jfri2/EV_DAQ_UNIT/Hardware/EV_DAQ_Unit.xlsx

Reference | Quantity | Quantity (2x) | Quantity (3x) | Value | Footprint | MFG# | DigiKey#
C11 C15 C19 C21 C22 C29 C30 C31 C38 C39 C4 C40 | 12 | 24 | 36 | 10uF | 1210 | TPSB106K020R0500 | 478-9048-1-ND
C23 C24 | 2 | 4 | 6 | 18pF | 603 | GRM1885C1H180FA01J | 490-10706-1-ND
C27 | 1 | 2 | 3 | 100uF | 2917 | T495D107M016ATE125 | 399-8502-1-ND
C1 C2 C37 | 3 | 6 | 9 | 10nF | 805 | GRM2195C1H103FA01D | 490-8295-1-ND
C10 C12 C13 C14 C16 C20 C25 C26 C28 C3 C32 C33 C34 C35 C41 C6 C8 | 17 | 34 | 51 | 100nF | 603 | C0603C104K3RACTU | 399-1281-1-ND
C36 C5 C7 C9 | 4 | 8 | 12 | 1uF | 805 | C0805C105J4RACTU | 399-8001-1-ND
D1 D12 D13 D14 | 4 | 8 | 12 | GREEN | 2-SMD, Z-Bend | SSL-LXA228GC-TR31 | SSL-LXA228GC-TR31
D10 D11 D8 D9 | 4 | 8 | 12 | CUS08F30 | SOD-323/SC-76 | CUS08F30,H3F | CUS08F30,H3F
D2 | 1 | 2 | 3 | S_RED | 2-SMD, Z-Bend | SSL-LXA228IC-TR31 | SSL-LXA228IC-TR31
D3 | 1 | 2 | 3 | 18V | SMA | 1SMA5931BT3G | 1SMA5931BT3GOSCT-ND
D6 D7 | 2 | 4 | 6 | YELLOW | 2-SMD, Z-Bend | SSL-LXA228YC-TR31 | 67-1392-1-ND
F1 | 1 | 2 | 3 | 500mA | 1812 | 0ZCG0050AF2C | 507-1762-1-ND
FB1 FB2 | 2 | 4 | 6 | BKP2125HS330-T | 805 | BKP2125HS330-T | 587-1931-1-ND
P1 | 1 | 2 | 3 | LOAD_CELL |  | 282834-5 | A98336-ND
P2 | 1 | 2 | 3 | PWR |  | 282834-2 | A98333-ND
P3 | 1 | 2 | 3 | AVR_ISP |  | PRPC040SAAN-RC | S1011EC-40-ND
P4 | 1 | 2 | 3 | USB_B |  | 61729-1011BLF | 609-3657-ND
P5 | 1 | 2 | 3 | HALL_EFFECT |  | 282834-6 | A98337-ND
R10 | 1 | 2 | 3 | 3.9k | 603 | RC0603FR-073K9L | 311-3.90KHRCT-ND
R13 R14 R26 R27 R30 R36 R38 | 7 | 14 | 21 | 470 | 805 | RC0805JR-07470RL | 311-470ARCT-ND
R11 R12 R15 R16 R17 R18 R19 R20 R21 R22 R23 R25 R33 R34 R35 R7 R8 | 17 | 34 | 51 | 39 | 603 | ESR03EZPJ390 | RHM39DCT-ND
R1 R2 R24 R3 R31 R32 R4 | 7 | 14 | 21 | 10k | 603 | ESR03EZPJ103 | RHM10KDCT-ND
R5 R6 R28 R29 R37 R39 R40 | 7 | 14 | 21 | 1k | 603 | RNCP0603FTD1K00 | RNCP0603FTD1K00CT-ND
R9 | 1 | 2 | 3 | 499 | 603 | RP73PF1J499RBTDF | A110079CT-ND
SW1 SW2 SW3 | 3 | 6 | 9 | SWITCH | TH | B3F-1022 | SW403-ND
U1 | 1 | 2 | 3 | LM4040-3.0V | SOT-23-3 | LM4040C30IDBZR | 296-20887-1-ND
U10 U12 | 2 | 4 | 6 | NCP5501-3V3 | DPAK-3 | NCP5501DT33RKG | NCP5501DT33RKGOSCT-ND
U11 | 1 | 2 | 3 | NCP5501-5V | DPAK-3 | NCP5501DT33RKG | NCP5501DT33RKGOSCT-ND
U2 | 1 | 2 | 3 | AD8226 | SOIC-8 | AD8226ARZ-R7 | AD8226ARZ-R7CT-ND
U3 | 1 | 2 | 3 | NHD-C0216CiZ | TH-CUSTOM | NHD-C0216CIZ-FSW-FBW-3V3 | NHD-C0216CIZ-FSW-FBW-3V3-ND
U4 | 1 | 2 | 3 | AD8616 | SOIC-8 | AD8616ARZ | AD8616ARZ-ND
U5 | 1 | 2 | 3 | LM2937-10V | SOT-223-4 | LM2937IMPX-10/NOPB | LM2937IMPX-10/NOPBCT-ND
U6 | 1 | 2 | 3 | FT232RL | SSOP-28 | FT232RL-REEL | 768-1007-1-ND
U7 | 1 | 2 | 3 | 74HC7014 | SOIC-14 | 74HC7014D,118 | 568-8162-1-ND
U13 U8 | 2 | 4 | 6 | TPD4E1U06 | SOT23-6 | TPD4E1U06DBVR | 296-35965-1-ND
U9 | 1 | 2 | 3 | TXB0106 | TSSOP-16 | TXB0106PWR | 296-23759-1-ND
U14 | 1 | 2 | 3 | ATMEGA328PB | 32 TQFP 0.8mm | ATMEGA328PB-AU | ATMEGA328PB-AU-ND
Y1 | 1 | 2 | 3 | 16_MHz | HC49-SMD | AT-16.000MAGE-T | 887-1608-1-ND
