jfri2/EV_DAQ_UNIT/Hardware/PDFs/EV_DAQ_Unit.pdf

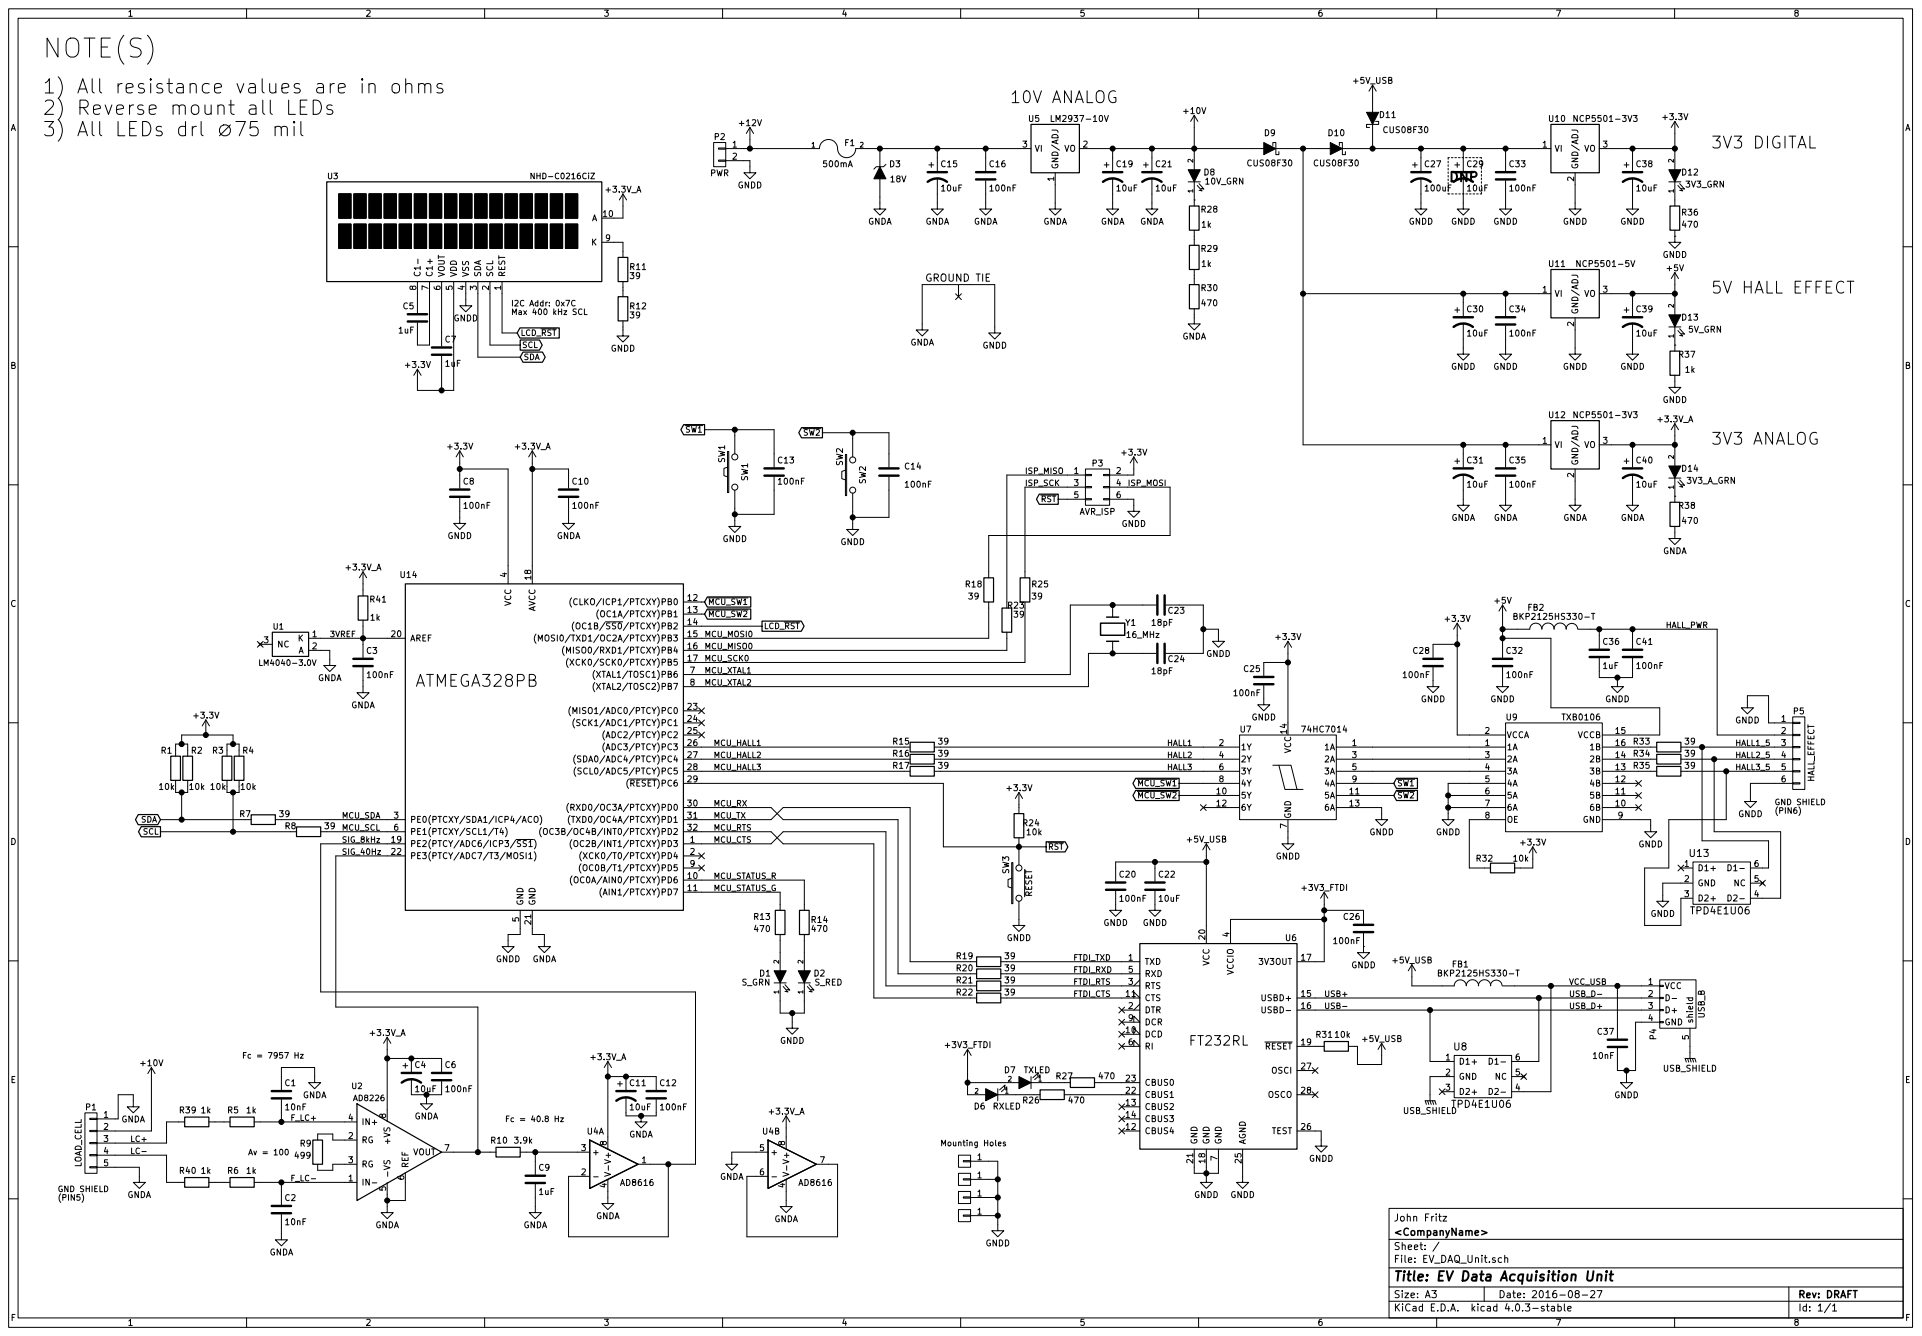
[picture p1: page 1]

NOTE(S)
10k 1) All resistance values are in ohms
2) Reverse mount all LEDs
3) All LEDs drl 75 mil

I2C Addr: 0x7C Max 400 kHz SCL

7 DCR 9 DCD 10 VCC 20 CTS 11 GND 21 CBUS4 12 CBUS1 22 CBUS2 13 CBUS0 23 CBUS3 14 USBD+ 15 AGND 25 USBD- 16 TEST 26

John Fritz
File: EV_DAQ_Unit.sch Sheet: / <CompanyName>

Id: 1/1 Title: EV Data Acquisition Unit
