jfri2/EV_DAQ_UNIT/Hardware/PDFs/EV_DAQ_Unit-B.CrtYd.pdf

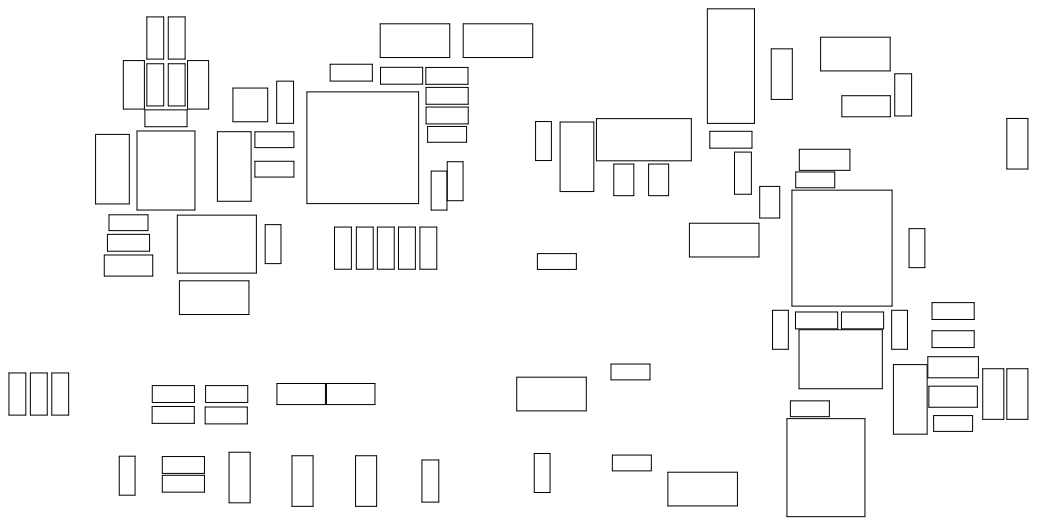
[picture p2: page 1]
