jfri2/EV_DAQ_UNIT/Hardware/PDFs/EV_DAQ_Unit-B.Cu.pdf

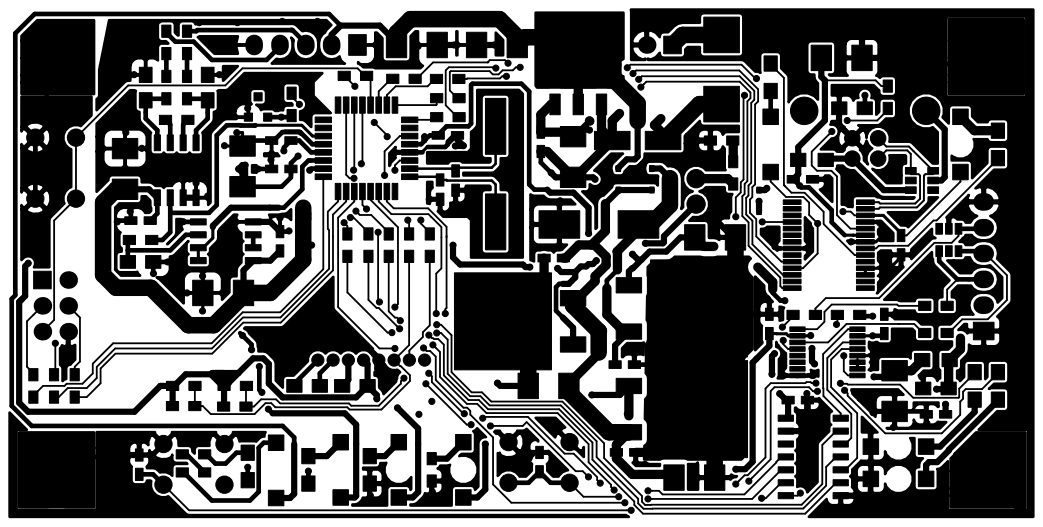
[picture p3: page 1]
