jfri2/EV_DAQ_UNIT/Hardware/PDFs/EV_DAQ_Unit-B.Mask.pdf

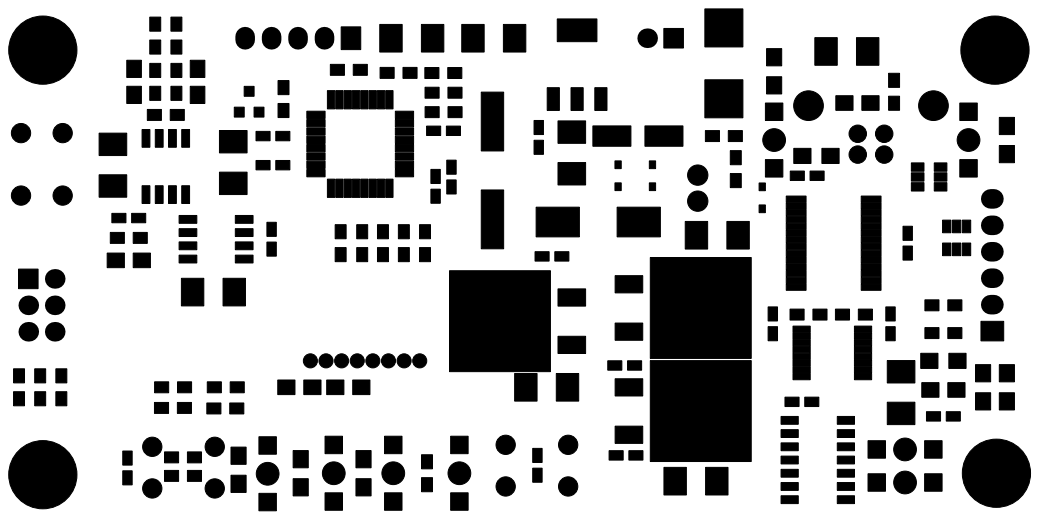
[picture p4: page 1]
