jfri2/EV_DAQ_UNIT/Hardware/PDFs/EV_DAQ_Unit-B.Paste.pdf

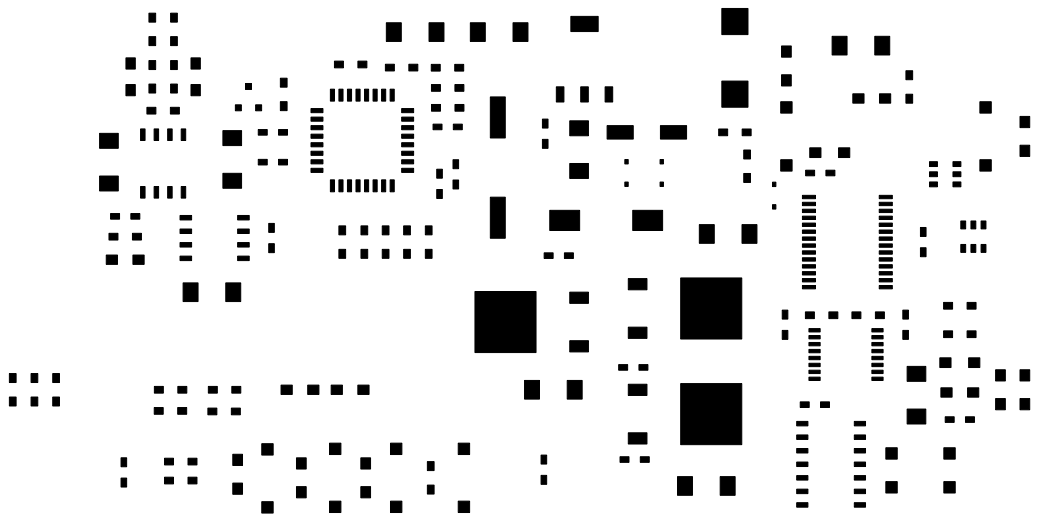
[picture p5: page 1]
