jfri2/EV_DAQ_UNIT/Hardware/PDFs/EV_DAQ_Unit-B.SilkS.pdf

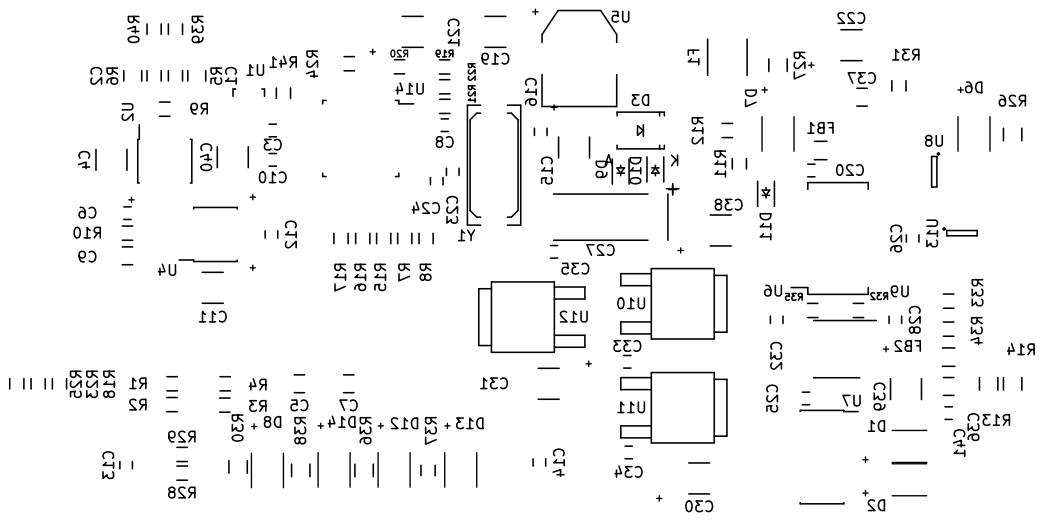
[picture p6: page 1]
