jfri2/EV_DAQ_UNIT/Hardware/PDFs/EV_DAQ_Unit-F.CrtYd.pdf

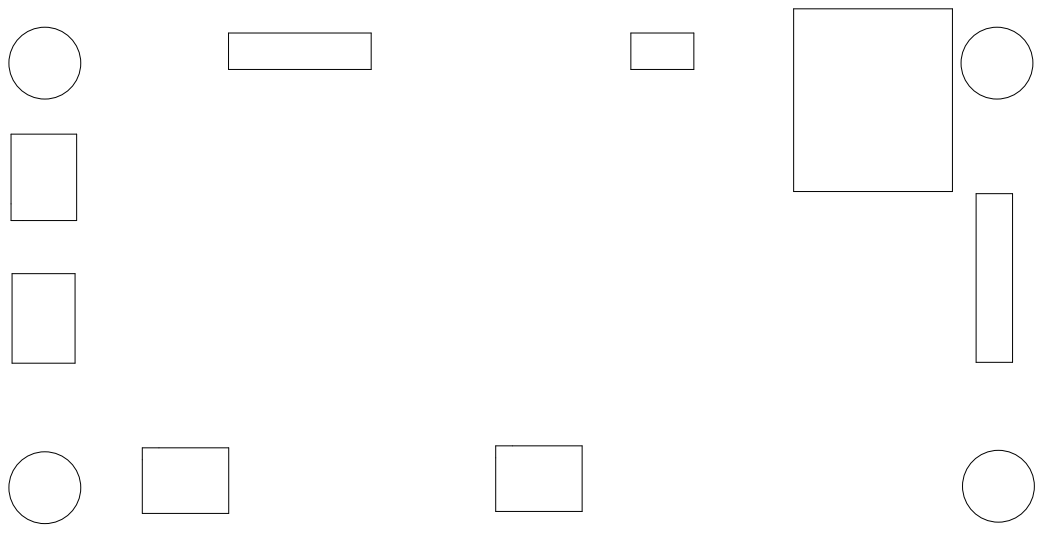
[picture p7: page 1]
