jfri2/EV_DAQ_UNIT/Hardware/PDFs/EV_DAQ_Unit-F.Cu.pdf

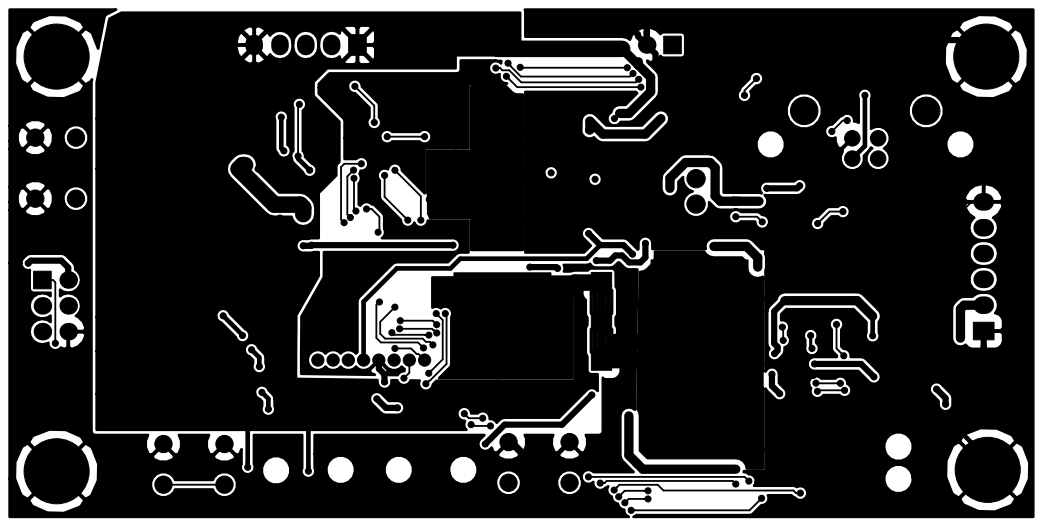
[picture p8: page 1]
