jfri2/EV_DAQ_UNIT/Hardware/PDFs/EV_DAQ_Unit-F.Mask.pdf

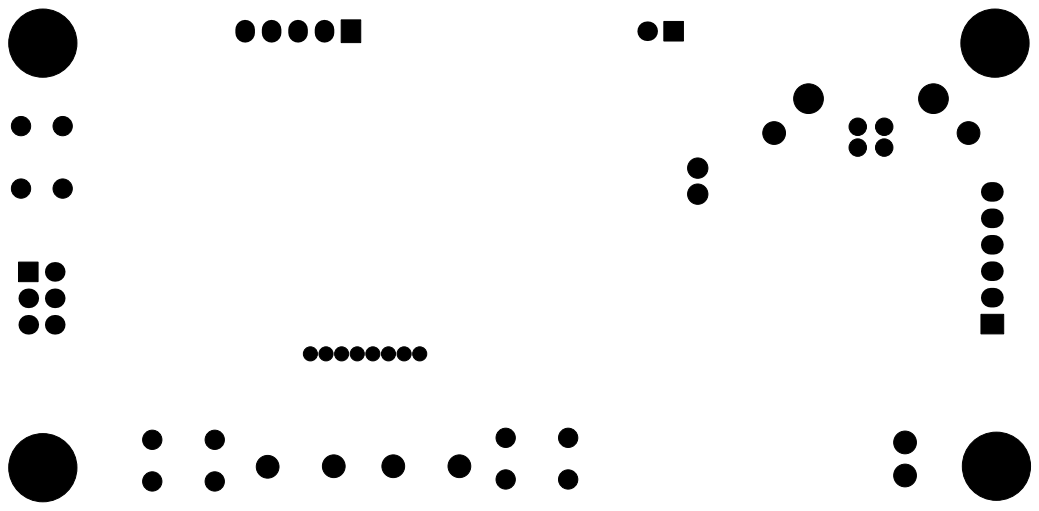
[picture p9: page 1]
