jfri2/EV_DAQ_UNIT/Hardware/PDFs/EV_DAQ_Unit-F.SilkS.pdf

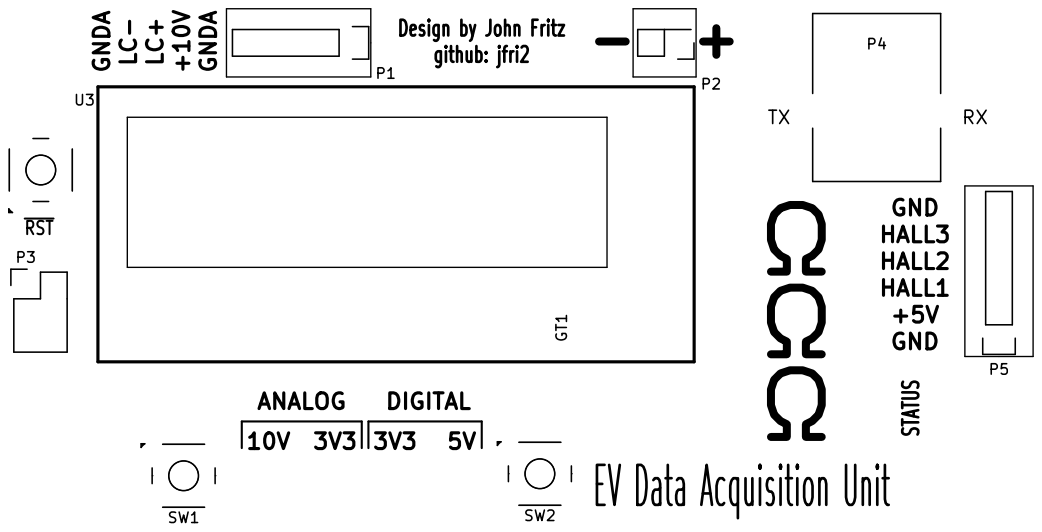
[picture p10: page 1]

Design by John Fritz
