jfri2/EV_DAQ_UNIT/Hardware/EV_DAQ_Unit.kicad_pcb

## KiCad design Hardware/EV_DAQ_Unit.kicad_pcb (2016-09-10)

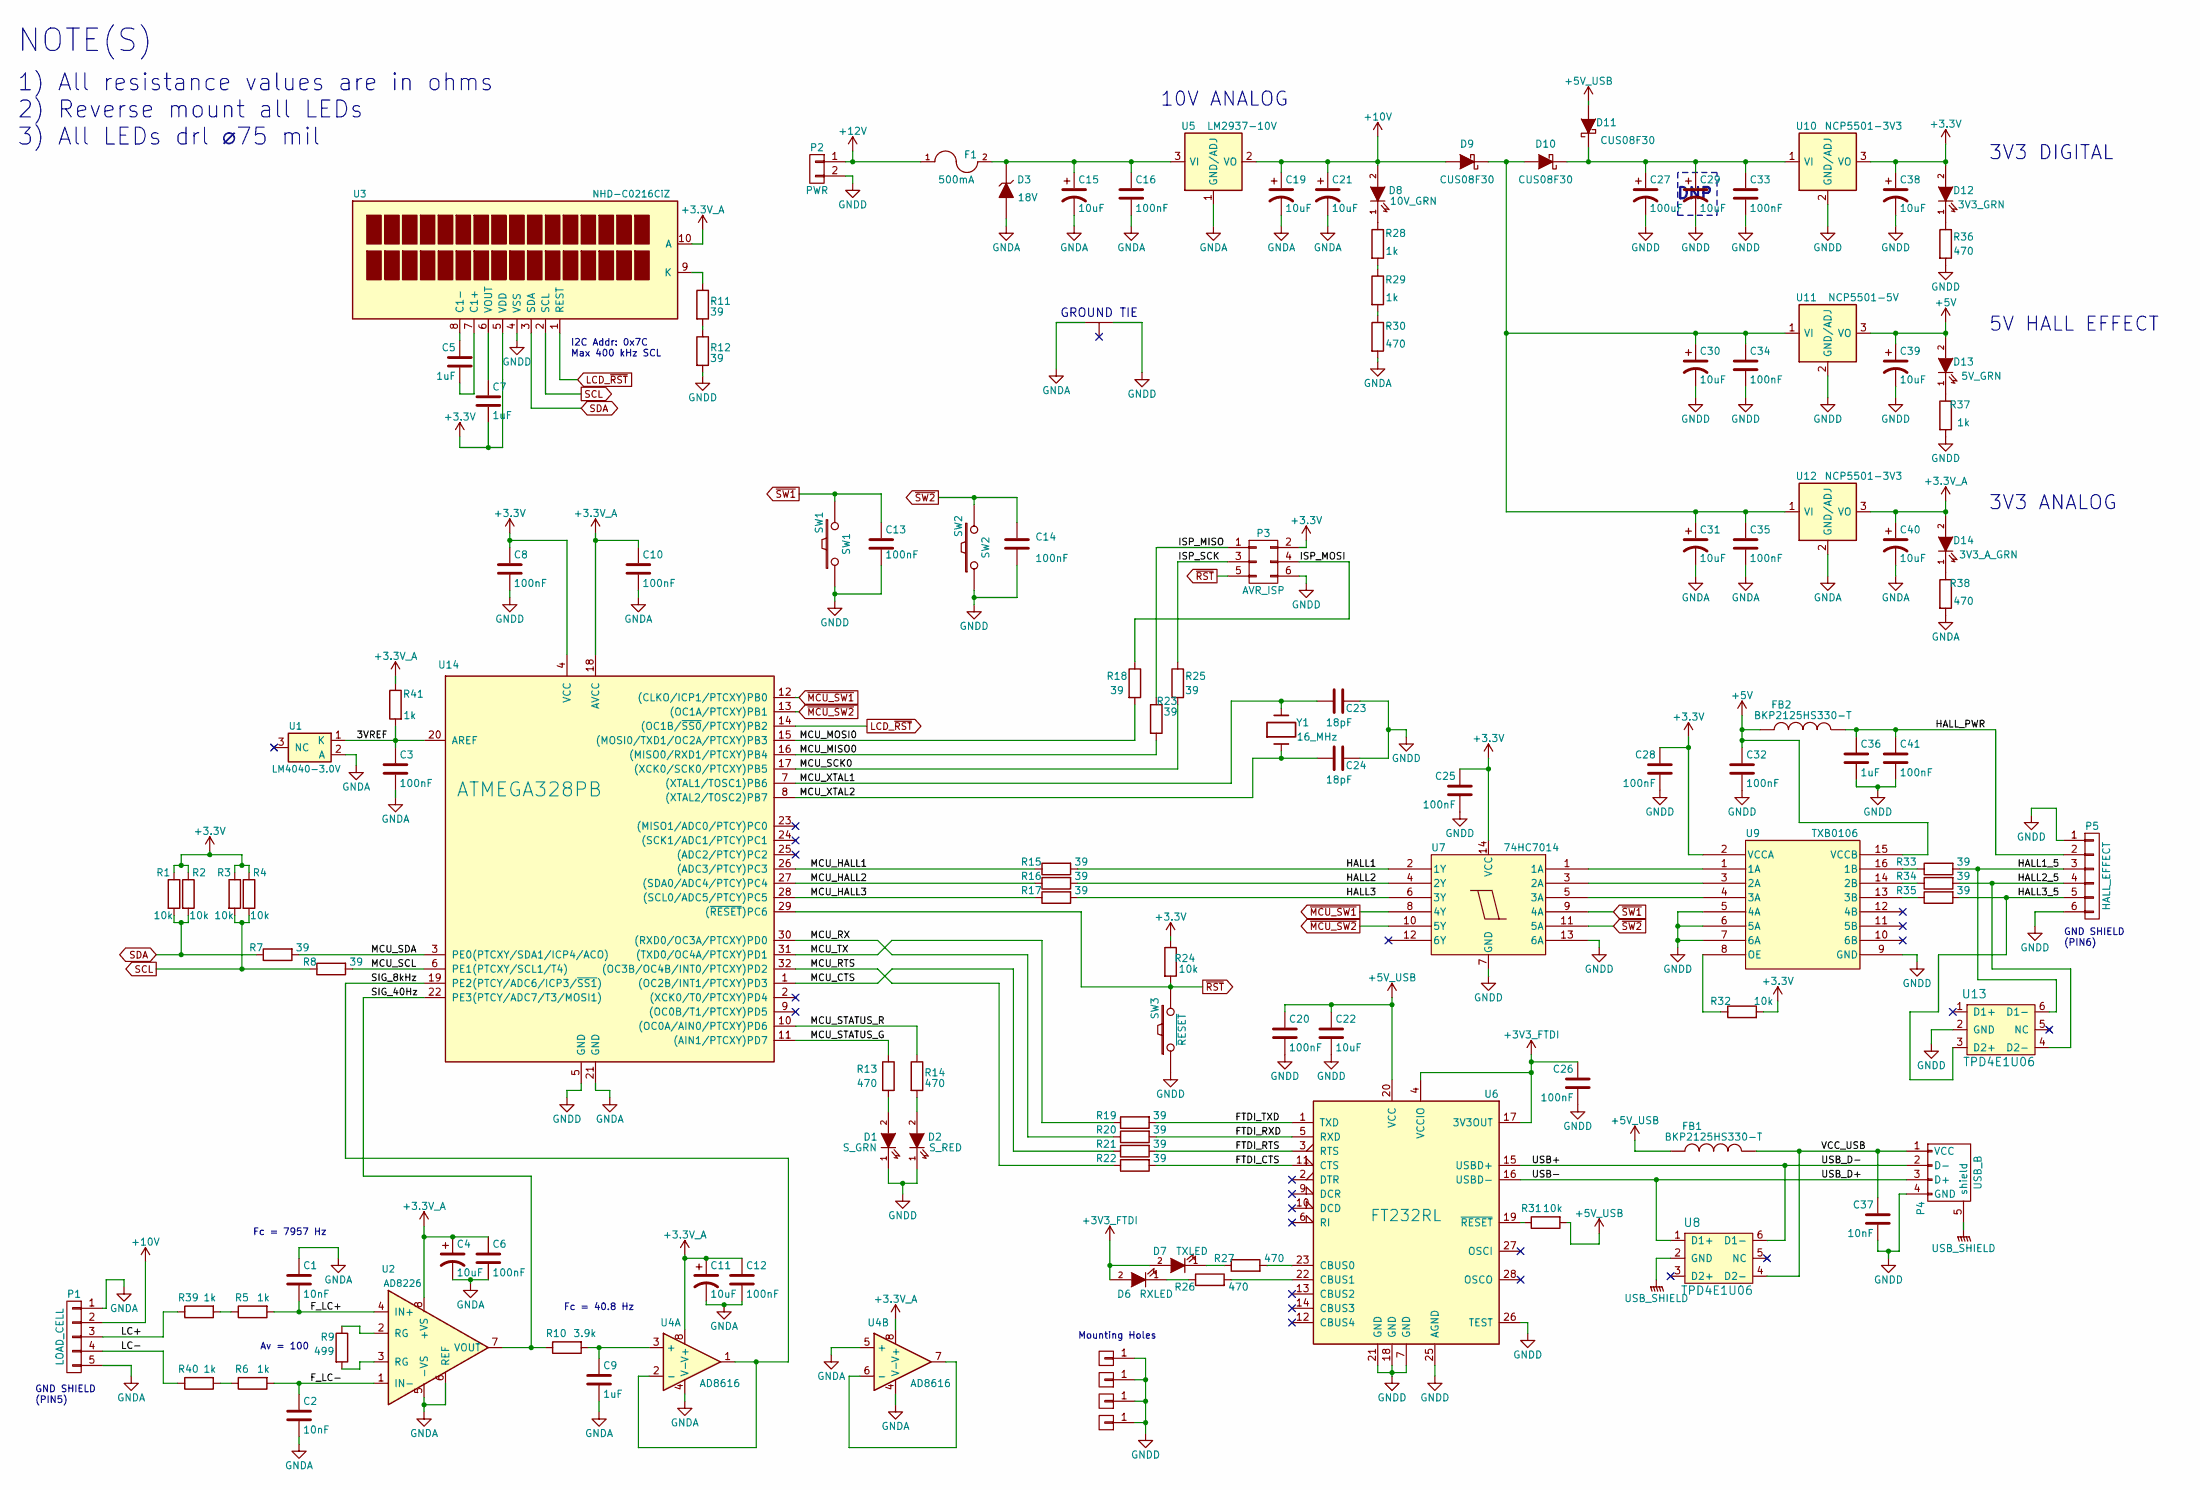
[picture p11: schematic EV_DAQ_Unit.sch, EV Data Acquisition Unit]

Parts:
C1, C2, C37: 10nF; C_0805_HandSoldering
C3, C6, C8, C10, C12, C13, C14, C16, C20, C25, C26, C28, C32, C33, C34, C35, C41: 100nF; C_0603_HandSoldering
C4, C11, C15, C19, C21, C22, C29, C30, C31, C38, C39, C40: 10uF; C_1210_HandSoldering_Polarized
C5, C7, C9, C36: 1uF; C_0805_HandSoldering
C23, C24: 18pF; C_0603_HandSoldering
C27: 100uF; TantalC_SizeD_EIA-7343_HandSoldering; MFG# T495D107M016ATE125
D1: S_GRN; 2-SMD_Z-Bend; MFG# SSL-LXA228GC-TR31
D2: S_RED; 2-SMD_Z-Bend; MFG# SSL-LXA228IC-TR31
D3: 18V; SMA_Handsoldering
D6: RXLED; 2-SMD_Z-Bend; MFG# SSL-LXA228YC-TR31
D7: TXLED; 2-SMD_Z-Bend; MFG# SSL-LXA228YC-TR31
D8: 10V_GRN; 2-SMD_Z-Bend; MFG# SSL-LXA228GC-TR31
D9, D10, D11: CUS08F30; SOD-323
D12: 3V3_GRN; 2-SMD_Z-Bend; MFG# SSL-LXA228GC-TR31
D13: 5V_GRN; 2-SMD_Z-Bend; MFG# SSL-LXA228GC-TR31
D14: 3V3_A_GRN; 2-SMD_Z-Bend; MFG# SSL-LXA228GC-TR31
F1: 500mA; R_1812_HandSoldering; MFG# 0ZCG0050AF2C
FB1, FB2: BKP2125HS330-T; R_0805_HandSoldering
GT1: GND_TIE; NetTie-II_Connected_SMD
P1: LOAD_CELL; 1x05_ScrewTerm
P2: PWR; 2x01_ScrewTerm
P3: AVR_ISP; Pin_Header_Straight_2x03
P4: USB_B
P5: HALL_EFFECT; 1x06_ScrewTerm
P7, P8, P9, P10: CONN_01X01; MountingHole_3.2mm_M3_Pad_Via
R1, R2, R3, R4, R24, R31, R32: 10k; R_0603_HandSoldering
R5, R6, R28, R29, R37, R39, R40, R41: 1k; R_0603_HandSoldering
R7, R8, R11, R12, R15, R16, R17, R18, R19, R20, R21, R22, R23, R25, R33, R34, R35: 39; R_0603_HandSoldering
R9: 499; R_0603_HandSoldering
R10: 3.9k; R_0603_HandSoldering
R13, R14, R26, R27, R30, R36, R38: 470; R_0805_HandSoldering
SW1: SW1; SW_TH_Tactile_Omron_B3F-10xx
SW2: SW2; SW_TH_Tactile_Omron_B3F-10xx
SW3: ~RESET; SW_TH_Tactile_Omron_B3F-10xx
U1: LM4040-3.0V; SOT-23
U2: AD8226; SOIC-8_3.9x4.9mm_Pitch1.27mm
U3: NHD-C0216CiZ; NHD-C0216CIZ
U4: AD8616; SOIC-8_3.9x4.9mm_Pitch1.27mm
U5: LM2937-10V; SOT-223
U6: FT232RL; SSOP-28_5.3x10.2mm_Pitch0.65mm
U7: 74HC7014; SOIC-14_3.9x8.7mm_Pitch1.27mm
U8, U13: TPD4E1U06; SOT-23-6
U9: TXB0106; TSSOP-16_4.4x5mm_Pitch0.65mm
U10, U12: NCP5501-3V3; SOT-428_ThermalVias
U11: NCP5501-5V; SOT-428_ThermalVias
U14: ATMEGA328PB; TQFP-32_7x7mm_Pitch0.8mm
Y1: 16_MHz; Q_49U3HMS

Connections:
+3.3V_A: C4.1, C6.1, C10.1, C11.1, C12.1, C40.1, D14.2 (A), R41.1, U2.8 (+VS), U3.10 (A), U4.8 (V+), U12.3 (VO), U14.18 (AVCC)
+3V3: C7.2, C8.1, C25.1, C28.1, C38.1, D12.2 (A), P3.2, R1.1, R2.1, R3.1, R4.1, R24.1, R32.2, U3.5 (VDD), U7.14 (VCC), U9.2 (VCCA), U10.3 (VO), U14.4 (VCC)
+3V3_FTDI: C26.1, D6.2 (A), D7.2 (A), U6.4 (VCCIO), U6.17 (3V3OUT)
+5V: C32.1, C39.1, D13.2 (A), FB2.2, U9.15 (VCCB), U11.3 (VO)
+5V_USB: C20.1, C22.1, D11.2 (A), FB1.2, R31.2, U6.20 (VCC)
+10V: C19.1, C21.1, D8.2 (A), D9.2 (A), P1.2, U5.2 (VO), U5.4 (VO)
+12V: F1.1, P2.1
/3VREF: C3.1, R41.2, U1.1 (K), U14.20 (AREF)
/FTDI_CTS: R22.2, U6.11 (CTS)
/FTDI_RTS: R21.2, U6.3 (RTS)
/FTDI_RXD: R20.2, U6.5 (RXD)
/FTDI_TXD: R19.2, U6.1 (TXD)
/F_LC+: C1.2, R5.2, U2.4 (IN+)
/F_LC-: C2.1, R6.2, U2.1 (IN-)
/HALL1: R15.2, U7.2 (1Y)
/HALL1_5: P5.3, R33.2, U13.6 (D1-)
/HALL2: R16.2, U7.4 (2Y)
/HALL2_5: P5.4, R34.2, U13.4 (D2-)
/HALL3: R17.2, U7.6 (3Y)
/HALL3_5: P5.5, R35.2, U13.3 (D2+)
/HALL_PWR: C36.1, C41.1, FB2.1, P5.2
/ISP_MISO: P3.1, R23.1
/ISP_MOSI: P3.4, R18.1
/ISP_SCK: P3.3, R25.1
/LC+: P1.3, R39.1
/LC-: P1.4, R40.1
/MCU_CTS: R21.1, U14.1 ((OC2B/INT1/PTCXY)PD3)
/MCU_HALL1: R15.1, U14.26 ((ADC3/PTCY)PC3)
/MCU_HALL2: R16.1, U14.27 ((SDA0/ADC4/PTCY)PC4)
/MCU_HALL3: R17.1, U14.28 ((SCL0/ADC5/PTCY)PC5)
/MCU_MISO0: R23.2, U14.16 ((MISO0/RXD1/PTCXY)PB4)
/MCU_MOSI0: R18.2, U14.15 ((MOSI0/TXD1/OC2A/PTCXY)PB3)
/MCU_RTS: R22.1, U14.32 ((OC3B/OC4B/INT0/PTCXY)PD2)
/MCU_RX: R20.1, U14.30 ((RXD0/OC3A/PTCXY)PD0)
/MCU_SCK0: R25.2, U14.17 ((XCK0/SCK0/PTCXY)PB5)
/MCU_SCL: R8.2, U14.6 (PE1(PTCXY/SCL1/T4))
/MCU_SDA: R7.2, U14.3 (PE0(PTCXY/SDA1/ICP4/ACO))
/MCU_STATUS_G: R13.1, U14.11 ((AIN1/PTCXY)PD7)
/MCU_STATUS_R: R14.1, U14.10 ((OC0A/AIN0/PTCXY)PD6)
/MCU_TX: R19.1, U14.31 ((TXD0/OC4A/PTCXY)PD1)
/MCU_XTAL1: C23.1, U14.7 ((XTAL1/TOSC1)PB6), Y1.2
/MCU_XTAL2: C24.1, U14.8 ((XTAL2/TOSC2)PB7), Y1.1
/SIG_8kHz: U4.1, U4.2 (-), U14.19 (PE2(PTCY/ADC6/ICP3/~SS1~))
/SIG_40Hz: R10.1, U2.7 (VOUT), U14.22 (PE3(PTCY/ADC7/T3/MOSI1))
/USB+: P4.2 (D-), U6.15 (USBD+), U8.6 (D1-)
/USB-: P4.3 (D+), U6.16 (USBD-), U8.1 (D1+)
/VCC_USB: C37.1, FB1.1, P4.1 (VCC), U8.4 (D2-)
GNDA: C1.1, C2.2, C3.2, C4.2, C6.2, C9.2, C10.2, C11.2, C12.2, C15.2, C16.2, C19.2, C21.2, C31.2, C35.2, C40.2, D3.2 (A), GT1.1, P1.1, P1.5, R30.2, R38.2, U1.2 (A), U2.5 (-VS), U2.6 (REF), U4.4 (V-), U4.5 (+), U5.1 (GND/ADJ), U12.2 (GND/ADJ), U14.21 (GND)
GNDD: C8.2, C13.2, C14.2, C20.2, C22.2, C23.2, C24.2, C25.2, C26.2, C27.2, C28.2, C29.2, C30.2, C32.2, C33.2, C34.2, C36.2, C37.2, C38.2, C39.2, C41.2, D1.1 (K), D2.1 (K), GT1.3, P2.2, P3.6, P4.4 (GND), P5.1, P5.6, P7.1, P8.1, P9.1, P10.1, R12.2, R36.2, R37.2, SW1.1, SW1.2 (1), SW2.1, SW2.2 (1), SW3.1, SW3.2 (1), U3.4 (VSS), U6.7 (GND), U6.18 (GND), U6.21 (GND), U6.25 (AGND), U6.26 (TEST), U7.7 (GND), U7.13 (6A), U9.5 (4A), U9.6 (5A), U9.7 (6A), U9.9 (GND), U10.2 (GND/ADJ), U11.2 (GND/ADJ), U13.2 (GND), U14.5 (GND)
LCD_~RST: U3.1 (REST), U14.14 ((OC1B/~SS0~/PTCXY)PB2)
unnamed: C5.1, U3.8 (C1-)
unnamed: C5.2, U3.7 (C1+)
unnamed: C7.1, U3.6 (VOUT)
unnamed: C9.1, R10.2, U4.3 (+)
unnamed: C15.1, C16.1, D3.1 (K), F1.2, U5.3 (VI)
unnamed: C27.1, C29.1, C33.1, D10.1 (K), D11.1 (K), U10.1 (VI)
unnamed: C30.1, C31.1, C34.1, C35.1, D9.1 (K), D10.2 (A), U11.1 (VI), U12.1 (VI)
unnamed: D1.2 (A), R13.2
unnamed: D2.2 (A), R14.2
unnamed: D6.1 (K), R26.1
unnamed: D7.1 (K), R27.1
unnamed: D8.1 (K), R28.1
unnamed: D12.1 (K), R36.1
unnamed: D13.1 (K), R37.1
unnamed: D14.1 (K), R38.1
unnamed: R9.1, U2.2 (RG)
unnamed: R9.2, U2.3 (RG)
unnamed: R11.1, U3.9 (K)
unnamed: R11.2, R12.1
unnamed: R26.2, U6.22 (CBUS1)
unnamed: R27.2, U6.23 (CBUS0)
unnamed: R28.2, R29.1
unnamed: R29.2, R30.1
unnamed: R31.1, U6.19 (~RESET~)
unnamed: R32.1, U9.8 (OE)
unnamed: R33.1, U9.16 (1B)
unnamed: R34.1, U9.14 (2B)
unnamed: R35.1, U9.13 (3B)
unnamed: R5.1, R39.2
unnamed: R6.1, R40.2
unnamed: U4.6 (-), U4.7
unnamed: U7.1 (1A), U9.1 (1A)
unnamed: U7.3 (2A), U9.3 (2A)
unnamed: U7.5 (3A), U9.4 (3A)
SCL: R3.2, R4.2, R8.1, U3.2 (SCL)
SDA: R1.2, R2.2, R7.1, U3.3 (SDA)
USB_SHIELD: P4.5 (shield), U8.2 (GND)
~MCU_SW1: U7.8 (4Y), U14.12 ((CLKO/ICP1/PTCXY)PB0)
~MCU_SW2: U7.10 (5Y), U14.13 ((OC1A/PTCXY)PB1)
~RST: P3.5, R24.2, SW3.3, SW3.4, U14.29 ((~RESET~)PC6)
~SW1: C13.1, SW1.3, SW1.4, U7.9 (4A)
~SW2: C14.1, SW2.3, SW2.4, U7.11 (5A)

Notes on the sheet:
GROUND TIE
1) All resistance values are in ohms 2) Reverse mount all LEDs 3) All LEDs drl ⌀75 mil
NOTE(S)
Fc = 7957 Hz
Fc = 40.8 Hz
I2C Addr: 0x7C Max 400 kHz SCL
GND SHIELD (PIN5)
GND SHIELD (PIN6)
Av = 100
3V3 DIGITAL
5V HALL EFFECT
3V3 ANALOG
10V ANALOG
Mounting Holes
DNP

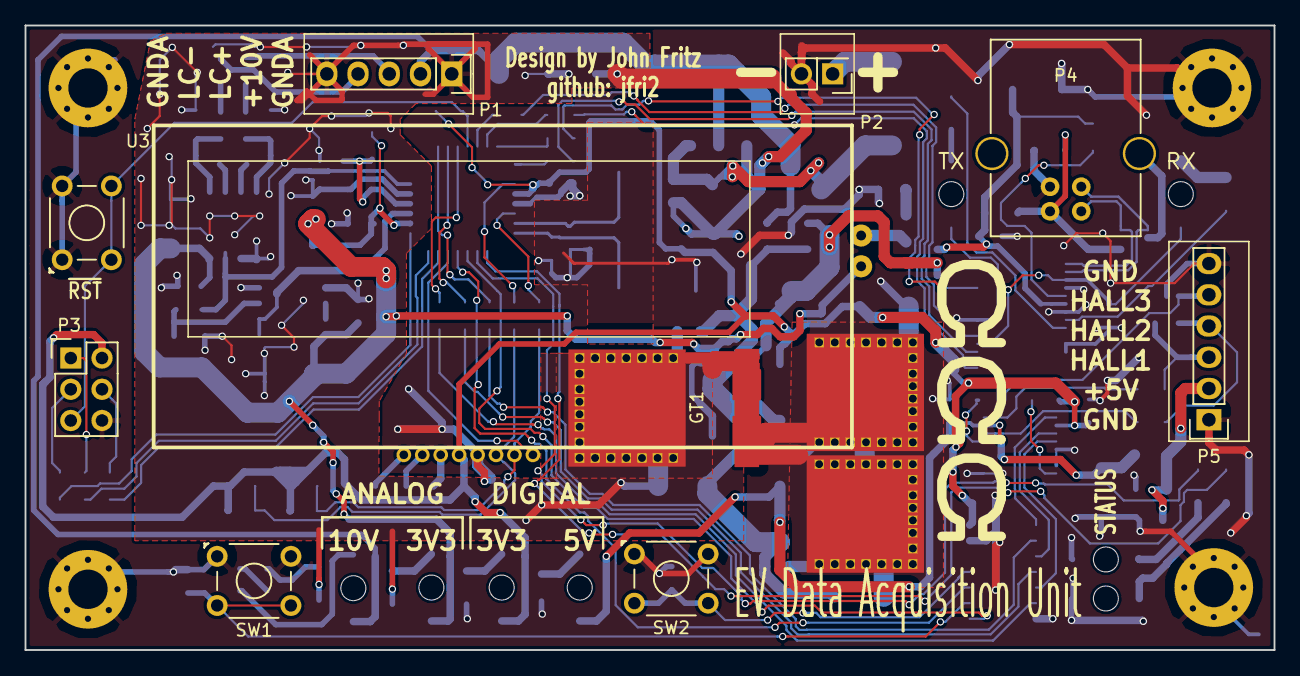
[picture p12: board EV_DAQ_Unit.kicad_pcb from above]

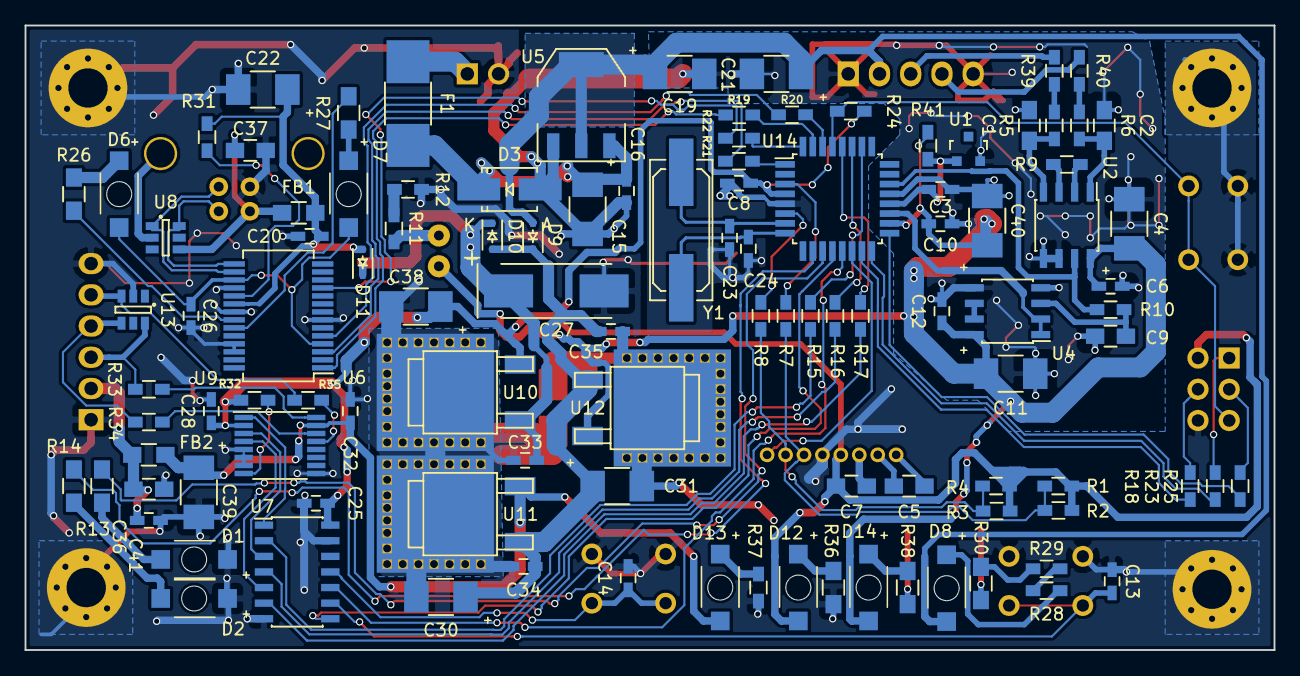
[picture p13: board EV_DAQ_Unit.kicad_pcb from below]

Board: 2 copper layers, 101.6 x 50.8 mm, 122 parts (108 on the bottom side), 92 nets.
