jfri2/EV_DAQ_UNIT/Software/EV_DAQ_Unit/EV_DAQ_Unit/random.h

// Length: 512
// Average: 34585.5625
uint16_t random_uint16_512[512] = {63311,101,45869,59017,42052,10140,55729,55378,33435,28596,49602,48038,62898,53815,58306,42769,35538,65183,53381,15711,45063,42921,1343,49573,28592,2637,56301,24588,18660,37727,49194,42361,63058,39394,17563,10001,62122,21186,36482,65072,21155,58963,15006,51026,8667,31942,21784,61476,56757,40619,20646,56192,62825,2790,57480,10480,42602,19221,43261,5707,62475,39965,61714,59206,5532,5471,65495,15945,14305,55276,62854,39960,32453,23397,16324,49414,10466,57777,8651,49637,2570,55837,30456,40209,53191,49576,56701,11816,43245,63,44135,29393,23551,2449,43555,63433,23119,58062,25550,45342,52221,40467,43461,16949,24750,53334,10370,64611,24238,12714,61150,14384,48830,47874,37451,34330,13993,60110,69,9254,56139,13455,60066,21931,2138,33653,3364,7774,11417,37606,54284,29290,30053,43679,64165,15154,22181,1838,51900,62686,43588,64929,28453,19038,64425,809,18190,5508,14196,3295,13270,60066,39373,29205,52297,47273,2507,23181,30889,60051,11540,28962,45202,20393,22731,56476,52398,19619,17301,59548,47854,63106,25569,14707,12446,31025,35771,64862,6433,36238,64829,51185,28137,42267,1713,24674,53829,49392,64708,22415,52868,65069,34066,36908,12823,10518,63331,43232,59094,55421,45309,46911,42640,36529,4385,62658,5096,8357,30512,43495,62116,61129,60300,26033,52115,55367,22762,33452,24658,13598,28416,34423,6477,58621,43401,13582,8437,8084,60510,32912,19453,38404,38555,52728,24481,55781,52537,63703,61702,47848,5256,32293,58337,61010,24647,2928,2380,41858,45369,60650,49629,33044,62542,62926,10906,7805,32195,2575,34920,29131,14799,42294,58541,35854,21687,36940,2035,62652,7450,55175,60787,61209,59168,21861,56298,58986,29766,8390,49074,35666,11712,4315,10705,35231,49232,27174,29952,42958,336,40795,14689,4357,63597,39917,65080,9864,19116,35411,36070,32052,48152,47494,52491,61975,57802,90,58320,40761,18466,63927,43993,23864,232,33088,30131,56690,27918,56923,29150,49117,50979,5273,15937,55583,13782,45406,46912,15011,24622,46630,47640,14190,29327,53970,64016,3370,18103,15930,45501,5840,47852,17422,47693,51495,24542,64929,35460,51666,18914,24286,44591,29592,28932,49454,43102,51150,18887,54416,44548,16067,14852,27599,18266,45146,28735,34992,49219,31987,56523,47696,6881,27611,40228,48221,4469,21199,58129,59848,41721,58198,7693,36341,47484,58107,62134,50417,32471,64895,45704,6172,24503,53270,44084,41843,21796,5985,54924,4798,25351,46742,37196,44274,49693,25867,44978,4628,8737,65198,37751,18268,22994,39886,14634,16640,35752,25382,29609,30108,15995,28812,55399,45919,42654,58549,1621,20827,15976,57210,47848,29509,29277,16347,17085,53270,37168,60726,9179,51572,63326,26947,2010,34948,15432,7201,38965,16324,15360,12362,496,51529,45863,47256,5214,3703,62512,49929,22747,46965,49526,17591,34605,51052,26764,21785,40411,41506,37362,31324,29326,6568,14272,22786,63578,19205,44330,48228,16426,65482,65235,5420,24121,33855,10849,60309,19898,55062,31630,24927,35999,6292,9278,30100,55413,4118,25692,14577,20773,2159,3984,40168,59498,17178,3010,64307,7787,46968,14612,19963,63079,12902,33405,4627};

// Length: 16
// Average: 32339.6875
// Sum: 517435
// Sorted: {809,8975,9327,14778,18685,24097,27717,29036,29827,41778,42757,46652,50741,53874,57590,60792}
uint16_t random_uint16_16[16] = {50741,14778,57590,27717,24097,53874,809,29827,9327,41778,18685,29036,8975,46652,42757,60792};
