jfri2/EV_DAQ_UNIT/Software/EV_DAQ_Unit/EV_DAQ_Unit/data_types.h

/** @file data_types.h
*
* @brief Global data type definitions
*
* @par
* COPYRIGHT NOTICE: (c) 2016 John Fritz
* All rights reserved
*/

#ifndef data_types_h__
#define data_types_h__

/* Boolean Type Definition */
typedef enum {FALSE, TRUE} bool;
    
#endif // data_types_h__
