jfri2/EV_DAQ_UNIT/Software/EV_DAQ_Unit/EV_DAQ_Unit/data_utils.h

/** @file data_utils.h
* @brief Contains various data processing utilities
*
* @par
* COPYRIGHT NOTICE: (c) 2016 John Fritz
* All rights reserved
*/

#ifndef data_utils_h__
#define data_utils_h__

#include <stdint.h>

void data_insertion_sort_uint16(uint16_t *data, uint16_t data_len);
uint16_t data_2n_average_uint16(uint16_t *data, uint16_t data_len);
void data_copy_uint16(uint16_t *data_from, uint16_t *data_to, uint16_t data_len);
void data_trim_uint16(uint16_t *data_from, uint16_t *data_to, uint16_t raw_len, uint16_t trim_val);

#endif // data_utils_h__
