jfri2/EV_DAQ_UNIT/(commit log)

2016-09-10 Initial Commit
    Hardware TODO: Regenerate gerbers with current KiCAD board files,
    regenerate PDFs for gerbers and schematic with current KiCAD design
    files.
    Software TODO: Finish driver definitions, Start/Finish library
    definitions, write hardware/software unit tests, start torque sensor
    application code, start speed application code, integration & test of
    combined torque and speed application
    [EV_DAQ_Unit-B.Cu.gbr, EV_DAQ_Unit-B.Mask.gbr, EV_DAQ_Unit-B.Paste.gbr, EV_DAQ_Unit-B.SilkS.gbr, EV_DAQ_Unit-Edge.Cuts.gbr, EV_DAQ_Unit-F.Cu.gbr, EV_DAQ_Unit-F.Mask.gbr, EV_DAQ_Unit-F.Paste.gbr]
2016-09-12 I2C driver implemented
    I2C driver implemented (untested) - somethings wrong with the linker
    scripts, at the moment the project will not build
    [i2c.c, i2c.h, main.c]
2016-09-12 Refactored some I2C variables&constants
2016-09-12 Added UART/STDIO driver
2016-09-13 Refactored & Fixed linker stuff
    [adc.c, adc.h, gpio.c, gpio.h, hall_effect.c, hall_effect.h, i2c.c, i2c.h]
2016-09-13 Implemented systck in Timer1, fixed linker stuff again
    [i2c.h, main.c, serial.c, serial.h, timer.c, timer.h]
2016-09-14 Started ADC driver. Implemented & tested 2n averaging function
2016-09-14 Implemented insertion sort for uint16 arrays of size up to 65535
2016-09-15 Finished ADC driver, added more functions to UART driver
2016-09-15 Changed some UART functions and added macros to main
2016-09-16 Replaced serial.c/h with uart.c/h. Refactor other things
    [data_utils.h, hall_effect.h, lcd.h, load_cell.h, main.c, timer.h, uart.c, uart.h]
2016-09-16 Added Print module
    This module will contain the STDIO routines for selectable printing over
    the LCD or UART
2016-09-16 Fixed spelling mistake in most c source files
    [adc.c, data_utils.c, hall_effect.c, lcd.c, lcd.h, load_cell.c, timer.c, uart.c]
2016-09-16 Changed print functionality to fprintf for both LCD & UART
    fprintf is now used as the default printing function. LCD or UART can be
    selected through the fprintf function call with the macros STDIO_UART or
    STDIO_LCD
2016-09-17 Refactored sys time implementation, added systck for general timing
    This allows me not to have to use util/delay.h provided that my 64 bit
    integer doesn't overflow (it won't)
    [EV_DAQ_Unit.h, timer.c]
2016-09-17 LCD I2C definitions started
2016-09-17 Changed some adc & util functions, added basic load cell reading functionality
2016-09-17 Fixed implementation of last commit
    [data_utils.h, load_cell.c, main.c]
2016-09-17 Removed FTDI module
    FTDI module only contained hardware flow control, this can now be
    implemented using the uart module. The UART module will be updated in
    the future
2016-09-18 Added flow control to UART, refactored stuff
2016-09-20 UART refactored, project rebuilt
2016-09-27 Implemented GPIO & status LED w/ <util/delay.h>
2016-09-27 Fixed systck & implemented custom delay function based on systck
    [lcd.c, main.c, timer.c, timer.h]
2016-09-28 Started ADC display. Refactored a ton of stuff
2016-09-29 Implemented and verified ADC
2016-09-29 Updated Force LCD print
